marcorainone/WsLoraTransponder/README.md

# WsLoraTransponder project

Project for the construction of transponders for various models of weather stations.

Development: Marco Rainone - ICTP Wireless Lab, 2019.
Specifications, revisions and debug:  Marco Zennaro, Ermanno Pietrosemoli, Marco Rainone - ICTP Wireless Lab

All the material is released under the terms of the MIT license.
