marcorainone/WsLoraTransponder/hardware/lopy4_v10_transponder_scheme.png

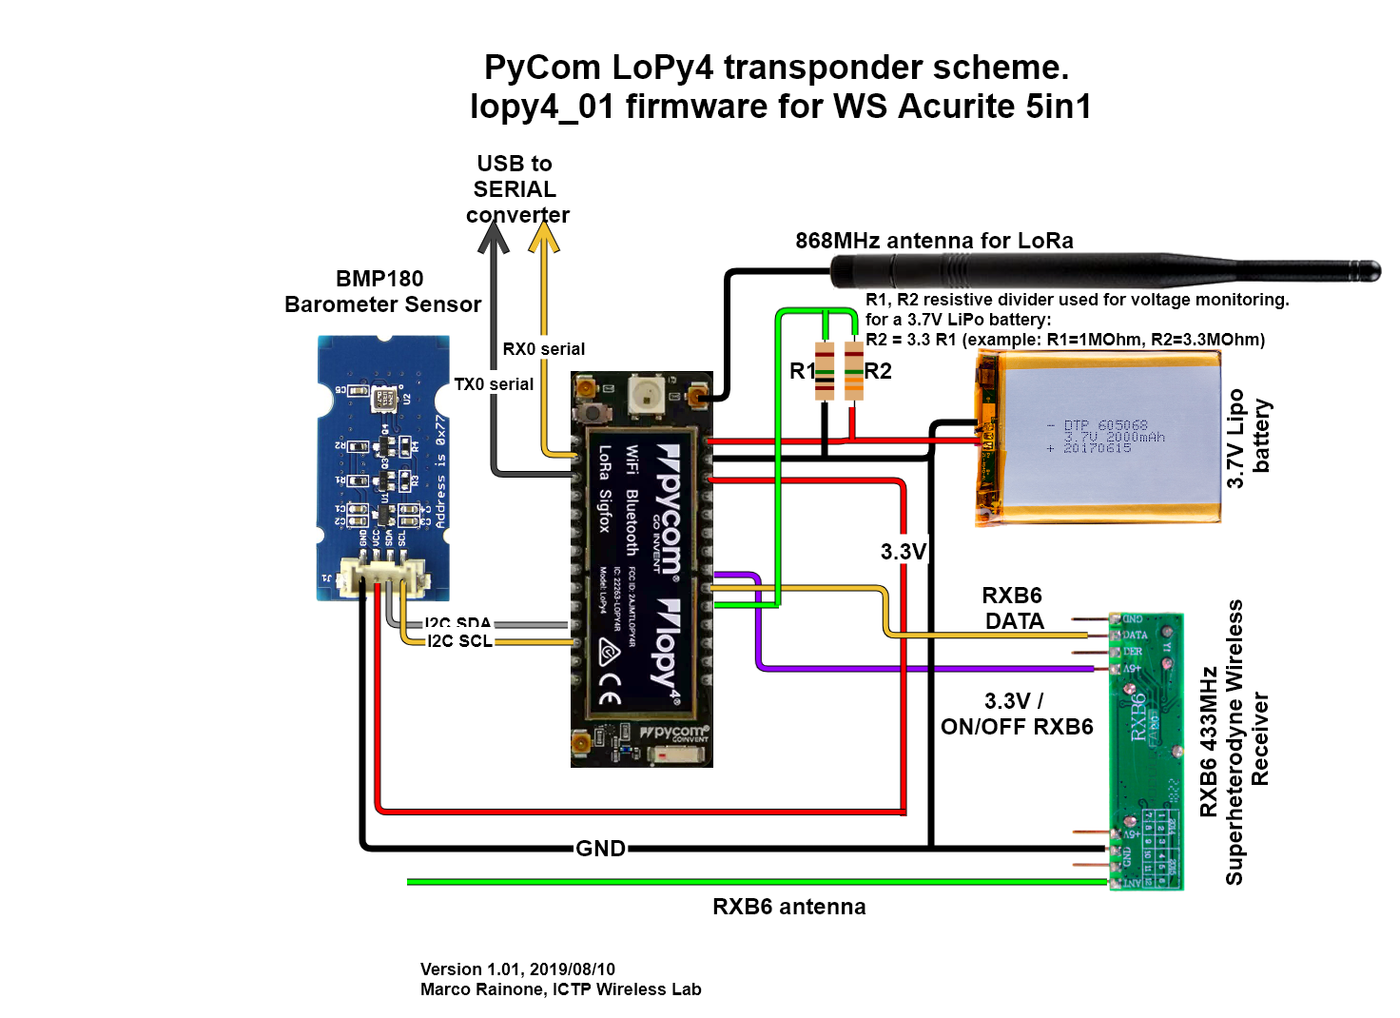
hardware/lopy4_v10_transponder_scheme.png
