marcorainone/WsLoraTransponder/hardware/lora32u4_v10_transponder_scheme.png

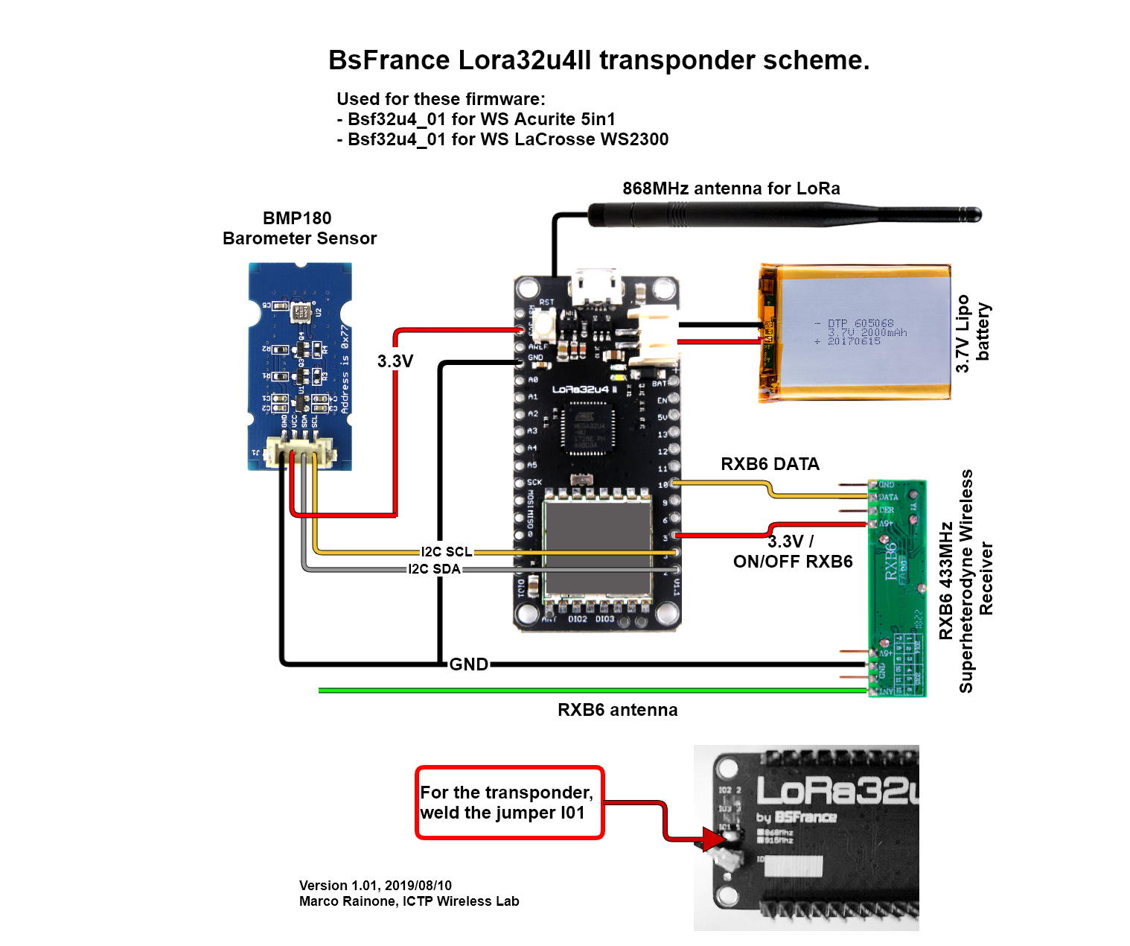
hardware/lora32u4_v10_transponder_scheme.png
