marcorainone/WsLoraTransponder/hardware/lora32u4_v11_transponder_scheme.png

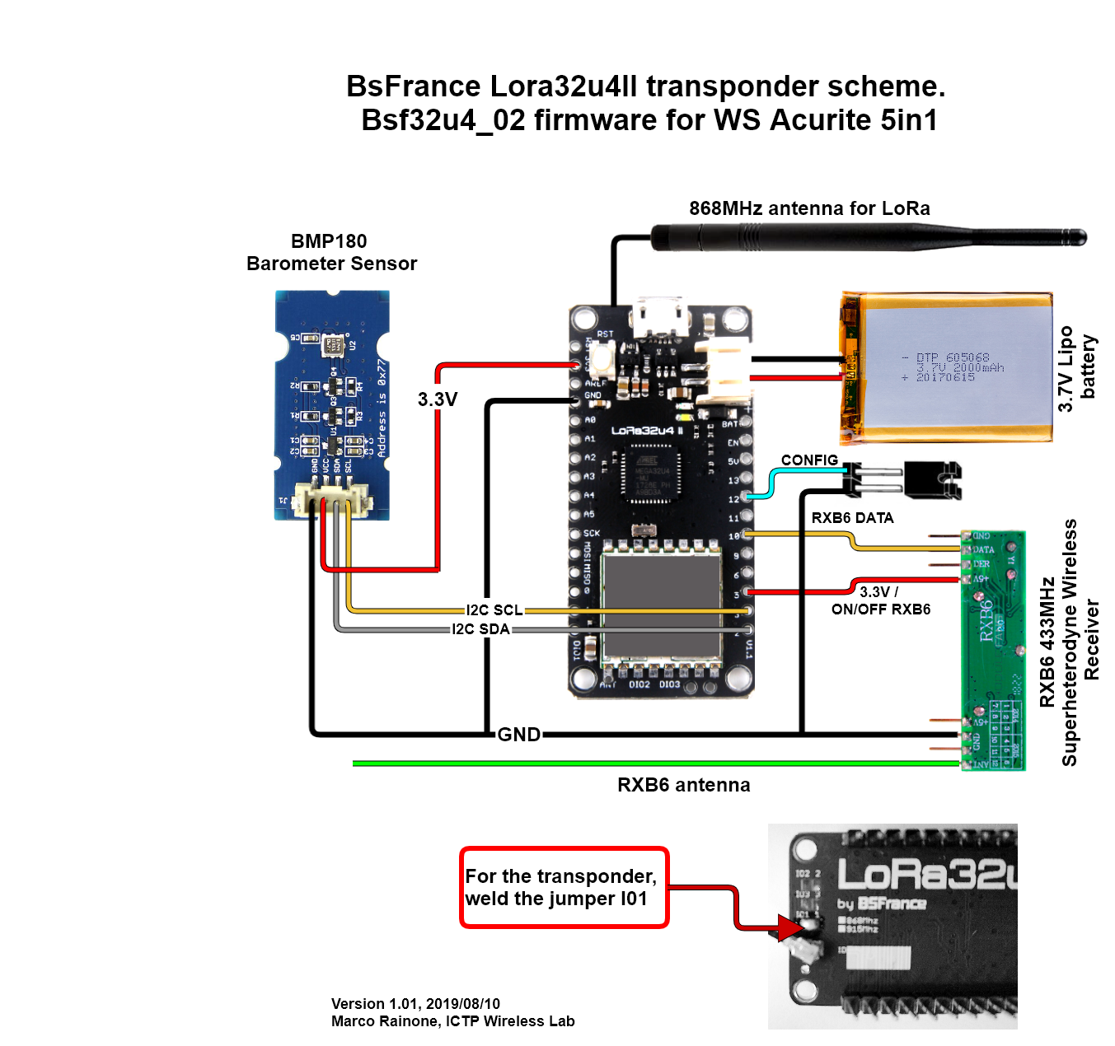
hardware/lora32u4_v11_transponder_scheme.png
