marcorainone/WsLoraTransponder/doc/operating_cycles_analysis_acurite_5in1_transponder.odt

Consumption analysis of transponder lora32u4II, firmware bsf32u4_01

Author: Marco Rainone

Document Version: 1.0

Date: 2019-08-28

This document analyzes a series of measurements with the Otii tool to illustrate the various operating phases of the Acurite 5in1 weather station acquisition firmware and the transponder consumption during these phases.

## Transponder lora32u4II. Firmware bsf32u4_01

Otii Supply voltage: 3.7V to simulate the power supply through lipo battery.

Hardware elements connected:

1. module BsFrance Lora32u4II
2. RXB6, OOK Etherodina receiver
3. Bosh BMP180, pressure and temperature sensor

### first active phase after power up

In this phase are carried out these operations:

1. hardware setup
2. TTN join
3. reading the first weather station message

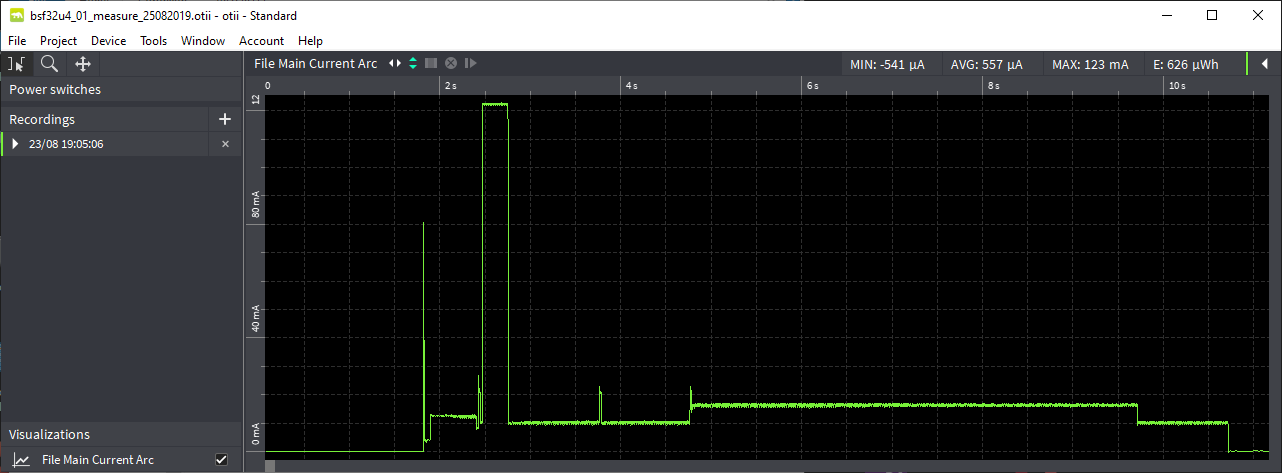
[picture p27: figure]

(https://www.acurite.com/learn/weather-stations/acurite-5-in-1-sensor)

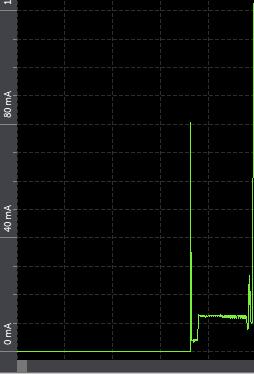
[picture p28: figure]

| Turning on the Lora32u4II module. The setup() is executed and proceeds with hardware configuration.

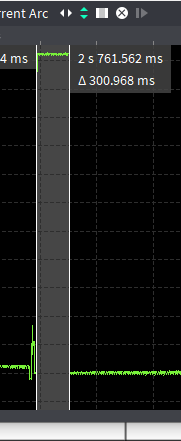
[picture p29: figure]

| TTN join phase via ABP. The duration of this phase is about 300msec. The consumption reaches 120mA

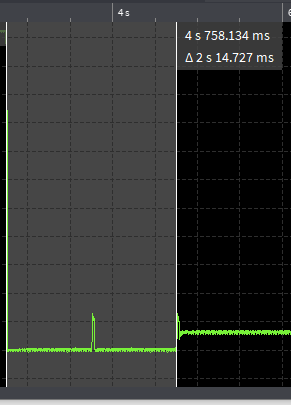
[picture p30: figure]

| After the TTN join phase, a preparation phase begins to receive messages of weather station. Except for a few very brief consumption peaks, consumption depends only on active phase of Lora32u4II. The the active phase average consumption of Lora32U4II is 10mA

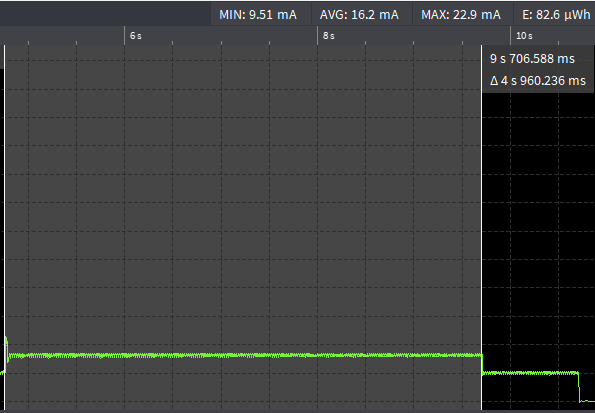
[picture p31: figure]

| In this phase the microcontroller turns on the RXB6 receiver. It remains on until it receives the first message from the weather station. The total consumption is the sum of the microcontroller and the etherodyne receiver consumption. In this phase the average consumption is 16.2mA. When the correct reception of the message is complete, the receiver is switched off and the consumption returns to 10mA again.

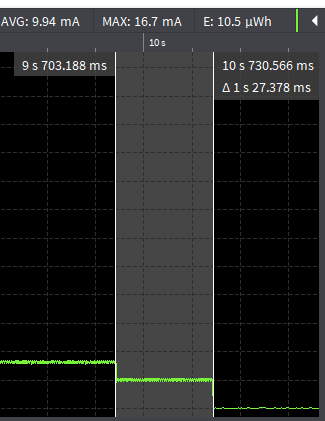
[picture p32: figure]

| Here we analyze the first weather station message. After that, we go in deep sleep waiting a specific time before to receive the second message. With the second message, the weather station has completed the delivery of its data.

### Second active phase: read of the second message. Send data to TTN

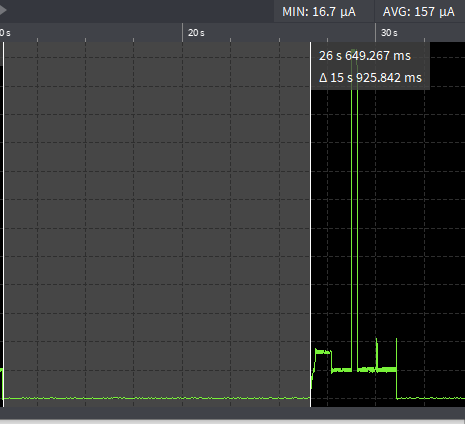
[picture p33: figure]

| The ws sends the second message 18 seconds after the first one. To reduce consumption, the microcontroller is sent in deep sleep before starting the second phase. In this case the consumption drops to 157uA.

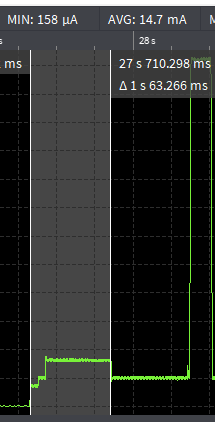
[picture p34: figure]

| The microcontroller wakes up and turns on the etherodyne receiver, which remains on until a message is completely received. The receiver is now turned off.

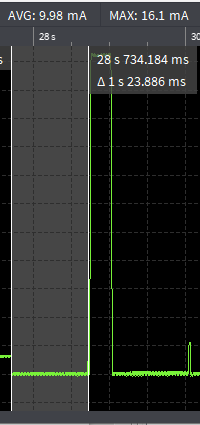
[picture p35: figure]

| The second message is analyzed. The BMP180 sensor data is acquired and the LoraWAN message is prepared to be sent to TTN. In this phase the consumption is around 10mA.

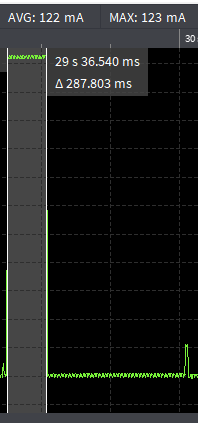
[picture p36: figure]

| Message transmission phase to TTN: this phase lasts 288msec and consumption results 122mA

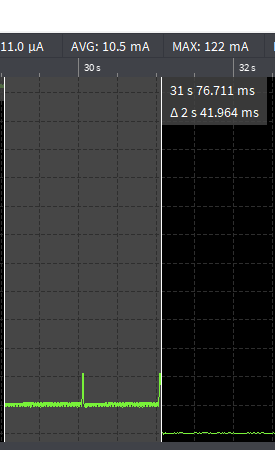
[picture p37: figure]

| Completed the transmission of the LoraWAN message, the lora chip is set to sleep. The consumption returns to the average of 10mA. the software has completed the steps. Finally, the deep sleep is activated before proceeding with the execution of a new cycle.

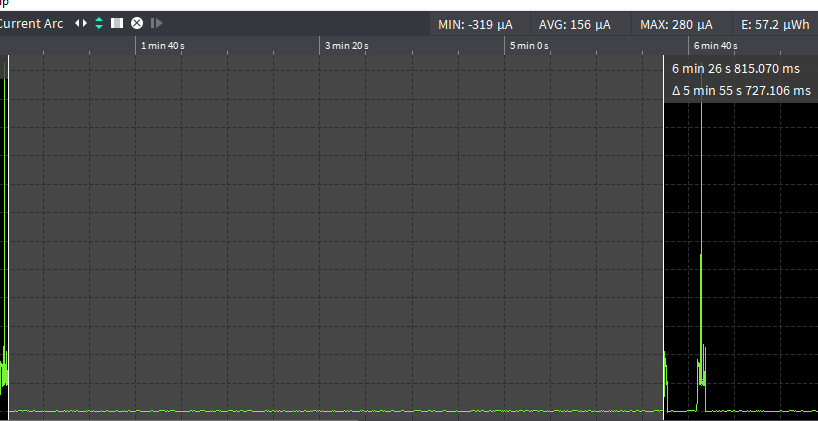
[picture p38: figure]

| The calculation of the duration of the deep sleep is based on the time set between message transmissions to TTN. In this phase, which in the example lasts 5min 55s, consumption is 156uA.

(https://www.acurite.com/learn/weather-stations/acurite-5-in-1-sensor)

### Following operating cycles

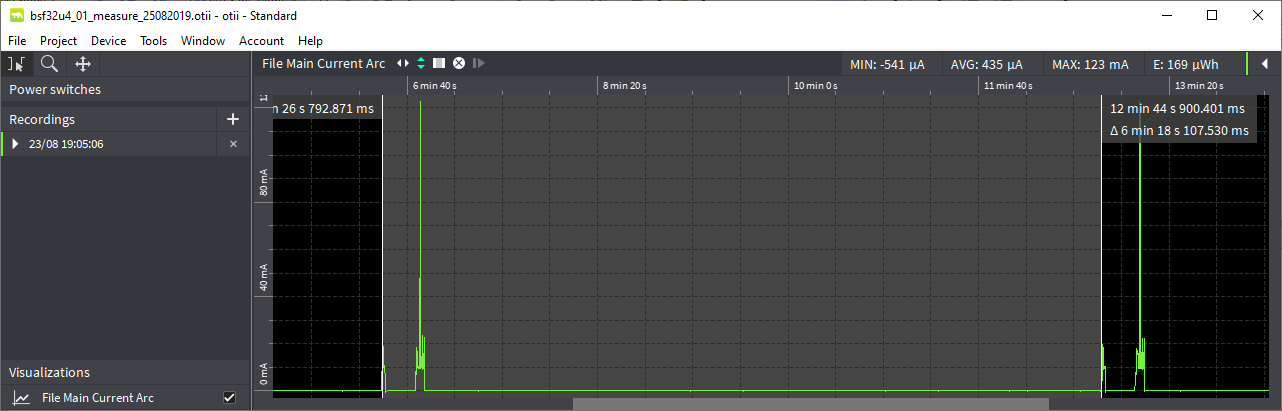
[picture p39: figure]

After the first cycle, they follow an indefinite series of successive cycles of equal duration, composed of the following phases:

1. Active phase of receiving the first message: it is different from that of the first cycle, because the TTN join is not re-executed.
2. deep sleep before proceeding to receive the second message
3. Active phase of receiving the second message and sending data to TTN: this phase is the same as that of the first cycle
4. Deep sleep phase before repeating the operating cycle again.

Transponder lora32u4II. Firmware bsf32u4_01 Versione 1

Transponder lora32u4II. Firmware bsf32u4_01 Version 1.0
