marcorainone/WsLoraTransponder/software/acurite5in1/BSFranceLora32u4II/bsf32u4_01/compile_results.txt

2019/08/28

Arduino compile results:

Sketch uses 25282 bytes (88%) of program storage space. Maximum is 28672 bytes.
Global variables use 1350 bytes of dynamic memory.
