marcorainone/WsLoraTransponder/software/lacrossews2300/BSFranceLora32u4II/bsf32u4_01/compile_results.txt

2019/08/28

Arduino compile results:

Sketch uses 23992 bytes (83%) of program storage space. Maximum is 28672 bytes.
Global variables use 1563 bytes of dynamic memory.
