marcorainone/WsLoraTransponder/software/acurite5in1/BSFranceLora32u4II/bsf32u4_02/src/BMP280/BMP280_DEV.h

/*
  BMP280 is an I2C/SPI compatible library for the Bosch BMP280 barometer.
	
	Copyright (C) Martin Lindupp 2019
	Modified by: Marco Rainone
	
	V1.0.0 -- Initial release 		
	V1.0.1 -- Added ESP32 HSPI support and change library to unique name
	V1.0.2 -- Modification to allow external creation of HSPI object on ESP32
	V1.0.3 -- Change library name in the library.properties file
	
	The MIT License (MIT)
	Permission is hereby granted, free of charge, to any person obtaining a copy
	of this software and associated documentation files (the "Software"), to deal
	in the Software without restriction, including without limitation the rights
	to use, copy, modify, merge, publish, distribute, sublicense, and/or sell
	copies of the Software, and to permit persons to whom the Software is
	furnished to do so, subject to the following conditions:
	The above copyright notice and this permission notice shall be included in all
	copies or substantial portions of the Software.
	THE SOFTWARE IS PROVIDED "AS IS", WITHOUT WARRANTY OF ANY KIND, EXPRESS OR
	IMPLIED, INCLUDING BUT NOT LIMITED TO THE WARRANTIES OF MERCHANTABILITY,
	FITNESS FOR A PARTICULAR PURPOSE AND NONINFRINGEMENT. IN NO EVENT SHALL THE
	AUTHORS OR COPYRIGHT HOLDERS BE LIABLE FOR ANY CLAIM, DAMAGES OR OTHER
	LIABILITY, WHETHER IN AN ACTION OF CONTRACT, TORT OR OTHERWISE, ARISING FROM,
	OUT OF OR IN CONNECTION WITH THE SOFTWARE OR THE USE OR OTHER DEALINGS IN THE
	SOFTWARE.
*/

#ifndef BMP280_DEV_h
#define BMP280_DEV_h

#include "Device.h"

////////////////////////////////////////////////////////////////////////////////
// BMP280_DEV Definitions
////////////////////////////////////////////////////////////////////////////////

/***
// original
#define BMP280_I2C_ADDR		 			0x77				// The BMP280 I2C address
#define BMP280_I2C_ALT_ADDR 			0x76				// The BMP280 I2C alternate address
***/
#define BMP280_I2C_ADDR		 			0x76				// The BMP280 I2C address
#define BMP280_I2C_ALT_ADDR 			0x77				// The BMP280 I2C alternate address

#define DEVICE_ID 						0x58				// The BMP280 device ID
#define RESET_CODE						0xB6				// The BMP280 reset code

// --------------------------------------------------------------
// LIBRARY CONFIGURATION
//
// define ENABLE_FLOAT_RESULTS	 if you want to use temperature in floating point
// #define ENABLE_FLOAT_RESULTS	
//
// enable EN_CALC_ALTITUDE if you want to calc altitude
// #define	EN_CALC_ALTITUDE

// --------------------------------------------------------------


enum SPIPort { BMP280_SPI0, BMP280_SPI1 };

////////////////////////////////////////////////////////////////////////////////
// BMP280_DEV Registers
////////////////////////////////////////////////////////////////////////////////

enum {
	BMP280_TRIM_PARAMS		 = 0x88,			// Trim parameter registers' base sub-address
	BMP280_DEVICE_ID 		 = 0xD0,			// Device ID register sub-address
	BMP280_RESET 			 = 0xE0,			// Reset register sub-address
	BMP280_STATUS      		 = 0xF3,			// Status register sub-address
	BMP280_CTRL_MEAS   		 = 0xF4,			// Control and measurement register sub-address
	BMP280_CONFIG       	 = 0xF5,			// Configuration register sub-address
	BMP280_PRES_MSB    		 = 0xF7,			// Pressure Most Significant Byte (MSB) register sub-address
	BMP280_PRES_LSB    		 = 0xF8,			// Pressure Least Significant Byte (LSB) register sub-address
	BMP280_PRES_XLSB   		 = 0xF9,			// Pressure eXtended Least Significant Byte (XLSB) register sub-address
	BMP280_TEMP_MSB    		 = 0xFA,			// Pressure Most Significant Byte (MSB) register sub-address
	BMP280_TEMP_LSB    	 	 = 0xFB,			// Pressure Least Significant Byte (LSB) register sub-address
	BMP280_TEMP_XLSB    	 = 0xFC 			// Pressure eXtended Least Significant Byte (XLSB) register sub-address
};          

////////////////////////////////////////////////////////////////////////////////
// BMP280_DEV Modes
////////////////////////////////////////////////////////////////////////////////

enum Mode {
	SLEEP_MODE          	 = 0x00,			// Device mode bitfield in the control and measurement register 
	FORCED_MODE         	 = 0x01,
	NORMAL_MODE         	 = 0x03,
};

////////////////////////////////////////////////////////////////////////////////
// BMP280_DEV Register bit field Definitions
////////////////////////////////////////////////////////////////////////////////

enum Oversampling {
	OVERSAMPLING_SKIP 		 = 0x00,     			// Oversampling bit fields in the control and measurement register
	OVERSAMPLING_X1   		 = 0x01,
	OVERSAMPLING_X2   		 = 0x02,
	OVERSAMPLING_X4  		   = 0x03,
	OVERSAMPLING_X8    		 = 0x04,
	OVERSAMPLING_X16   	 	 = 0x05
};

enum IIRFilter {
	IIR_FILTER_OFF  			 = 0x00,     			// Infinite Impulse Response (IIR) filter bit field in the configuration register
	IIR_FILTER_2    			 = 0x01,
	IIR_FILTER_4           = 0x02,
	IIR_FILTER_8           = 0x03,
	IIR_FILTER_16          = 0x04
};

enum TimeStandby {
	TIME_STANDBY_05MS      = 0x00,     		  // Time standby bit field in the configuration register
	TIME_STANDBY_62MS      = 0x01,
	TIME_STANDBY_125MS     = 0x02,
	TIME_STANDBY_250MS     = 0x03,
	TIME_STANDBY_500MS     = 0x04,
	TIME_STANDBY_1000MS    = 0x05,
	TIME_STANDBY_2000MS    = 0x06,
	TIME_STANDBY_4000MS    = 0x07
};

enum {
	IM_UPDATE              = 0x01,					// Status register bit fields
	MEASURING              = 0x08	
};

////////////////////////////////////////////////////////////////////////////////
// BMP280_DEV Class definition
////////////////////////////////////////////////////////////////////////////////

class BMP280_DEV : public Device {															// Derive the BMP280_DEV class from the Device class
	public:
		BMP280_DEV();																								// BMP280_DEV object for I2C operation
		BMP280_DEV(uint8_t cs);																			// BMP280_DEV object for SPI operation
#ifdef ARDUINO_ARCH_ESP32
		BMP280_DEV(uint8_t cs, uint8_t spiPort, SPIClass& spiClass);	// BMP280_DEV object for SPI1 with supplied SPIClass object
#endif
		uint8_t begin(Mode mode, 																		// Initialise the barometer with arguments
									Oversampling presOversampling, 
									Oversampling tempOversampling, 
									IIRFilter iirFilter, 
									TimeStandby timeStandby);
		uint8_t begin(Mode mode);																		// Initialise the barometer specifying start mode with default initialisation
		uint8_t begin(Mode mode, uint8_t addr);											// Initialise the barometer specifying start mode and I2C addrss
		uint8_t begin(uint8_t addr);																// Initialise the barometer specifying I2C address with default initialisation
		uint8_t begin();																						// Initialise the barometer in SLEEP_MODE with default initialisation
		void reset();																								// Soft reset the barometer		
		void startNormalConversion();																// Start continuous measurement in NORMAL_MODE
		void startForcedConversion();															  // Start a one shot measurement in FORCED_MODE
		void stopConversion();																			// Stop the conversion and return to SLEEP_MODE
		void setPresOversampling(Oversampling presOversampling);		// Set the pressure oversampling: OFF, X1, X2, X4, X8, X16
		void setTempOversampling(Oversampling tempOversampling);		// Set the temperature oversampling: OFF, X1, X2, X4, X8, X16
		void setIIRFilter(IIRFilter iirFilter);											// Set the IIR filter setting: OFF, 2, 4, 8, 16
		void setTimeStandby(TimeStandby timeStandby);	 							// Set the time standby measurement interval: 0.5, 62, 125, 250, 500ms, 1s, 2s, 4s

#ifdef ENABLE_FLOAT_RESULTS
		uint8_t getTemperature(float &temperature);									// Get a temperature measurement
		uint8_t getPressure(float &pressure);												// Get a pressure measurement
		uint8_t getTempPres(float &temperature, float &pressure);		// Get a temperature and pressure measurement
#else
		uint8_t getTemperature(long &temperature);									// Get a temperature measurement
		uint8_t getPressure(long &pressure);												// Get a pressure measurement
		uint8_t getTempPres(long &temperature, long &pressure);		// Get a temperature and pressure measurement
#endif					// #ifdef ENABLE_FLOAT_RESULTS

#ifdef	EN_CALC_ALTITUDE
		uint8_t getAltitude(float &altitude);												// Get an altitude measurement
		uint8_t getMeasurements(float &temperature, float &pressure, float &altitude);	// Get temperature, pressure and altitude measurements
#endif					// #ifdef	EN_CALC_ALTITUDE

	protected:
	private:
		void setMode(Mode mode);																		// Set the barometer mode
		void setCtrlMeasRegister(Mode mode, Oversampling presOversampling, Oversampling tempOversamping);		// Set the BMP280 control and measurment register
		void setConfigRegister(IIRFilter iirFilter, TimeStandby timeStandby);		// Set the BMP280 configuration register
		uint8_t checkMode();																				// Checks the barometer's mode before taking a measurement
		uint8_t writeMask;																					// Sub address mask for SPI communications
	
		struct {																										// The BMP280 compensation trim parameters (coefficients)
			uint16_t dig_T1;
			int16_t  dig_T2;
			int16_t  dig_T3;
			uint16_t dig_P1;
			int16_t  dig_P2;
			int16_t  dig_P3;
			int16_t  dig_P4;
			int16_t  dig_P5;
			int16_t  dig_P6;
			int16_t  dig_P7;
			int16_t  dig_P8;
			int16_t  dig_P9;
		} params;
			
		union {																											// Copy of the BMP280's configuration register
			struct {
				uint8_t spi3w_en : 1;
				uint8_t 				 : 1;
				uint8_t filter 	 : 3;
				uint8_t t_sb		 : 3;
			} bit;
			uint8_t reg;
		} config;
		
		union {																											// Copy of the BMP280's control and measurement register
			struct {
				uint8_t mode   : 2;
				uint8_t osrs_p : 3;
				uint8_t osrs_t : 3;
			} bit;
			uint8_t reg;
		} ctrl_meas;
			
		union {																											// Copy of the BMP280's status register
			struct {
				uint8_t im_update : 1;
				uint8_t						: 2;
				uint8_t measuring : 1;
			} bit;
			uint8_t reg;
		} status;
		
		int32_t t_fine;																							// Bosch t_fine variable
		int32_t bmp280_compensate_T_int32(int32_t adc_T);						// Bosch temperature compensation function
		uint32_t bmp280_compensate_P_int64(int32_t adc_P);					// Bosch pressure compensation function
};

#endif
